3Dator/3dator/3Dator.JPG

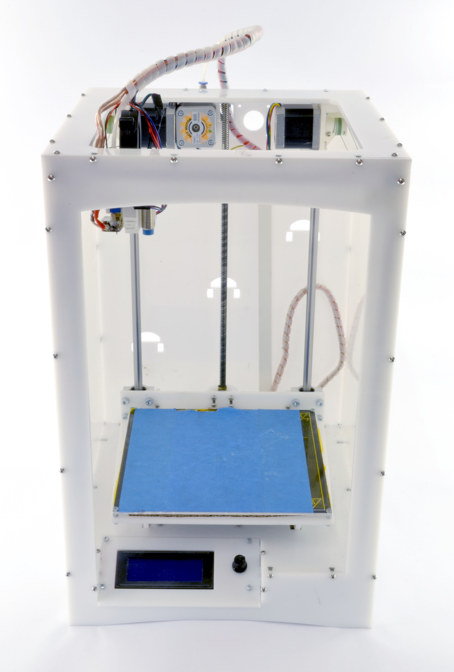
3Dator.JPG
