3Dator/3dator/README.md

3Dator
======

This repository will provide you with all informations on parts used in the 3Dator 3D printer.

For more information visit our website or wiki:
You will find a detailed list of all needed parts here: http://wiki.3dator.com/index.php/BOM

http://3dator.com

http://wiki.3dator.com

Please note that the material in this repository is licensed with the CC BY-NC-SA
