3Dator/3dator/dxf/Laser_layout.step

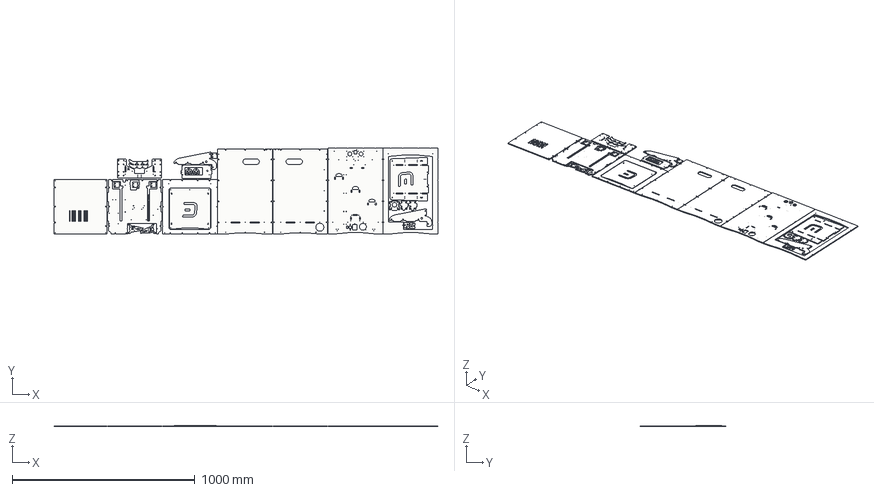
[picture p2: CAD file, 2017-05-03]
dxf/Laser_layout.step
2102.0 x 471.8 x 7.51 mm
case_display_tilter v3 x 2
case_display v3
z_sled_back v2
z_sled_support v2 x 2
z_sled_main v2
5mm_spacer v2 x 17
spool_holder_support v2 x 2
test_edge v2 x 4
z_motor_mount_support v2 x 2
z_motor_mount_main v3
z_nut_holder v3 x 2
case_left v4
case_floor v5
bed_carrier v6
case_front v4
case_right v3
case_top v7
case_bottom v4
case_back v7
spool_holder_main v2 x 2
