3Dator/3dator/Slicer profile/Cura 2.5/3dator_platform.stl

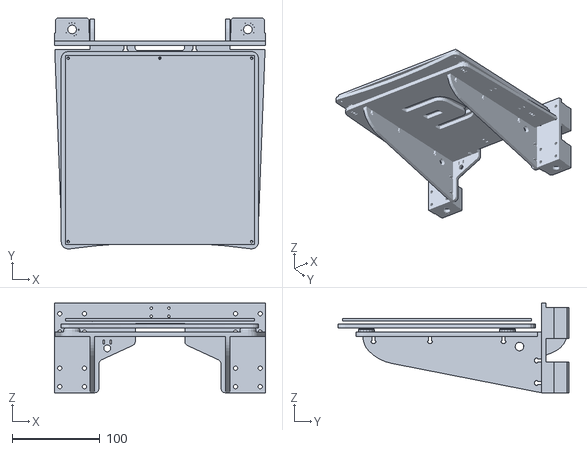
[picture p3: CAD file, 2017-05-23]
Slicer profile/Cura 2.5/3dator_platform.stl
240.0 x 262.7 x 102.0
