3Dator/3dator/step/extra/cable_anchor.stp

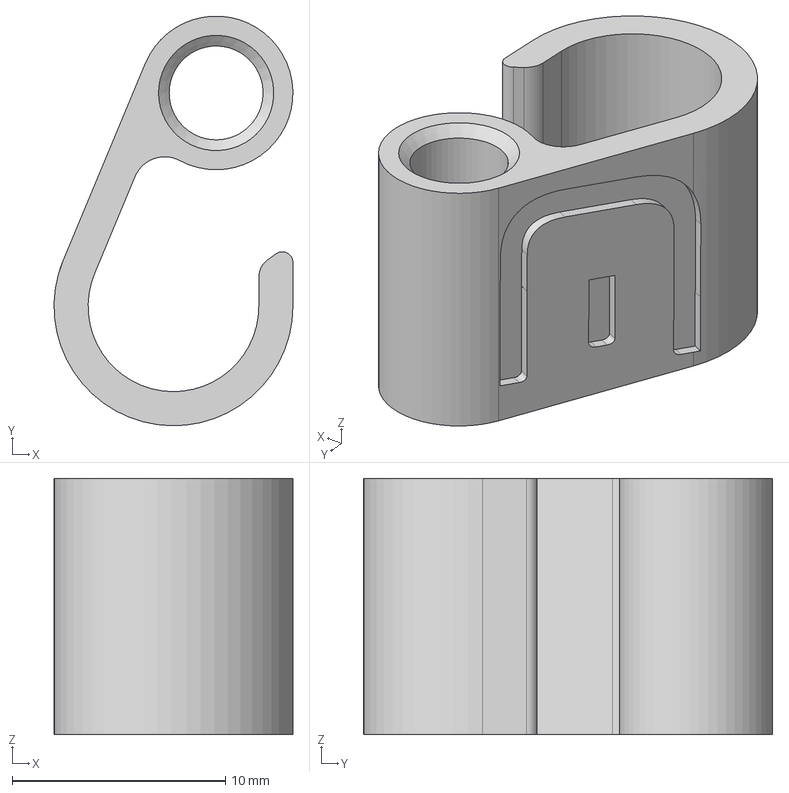
[picture p4: CAD file, 2017-03-16]
step/extra/cable_anchor.stp
11.2 x 19.2 x 12.0 mm
