3Dator/3dator/step/extra/extruder_mirrored/tightener.stp

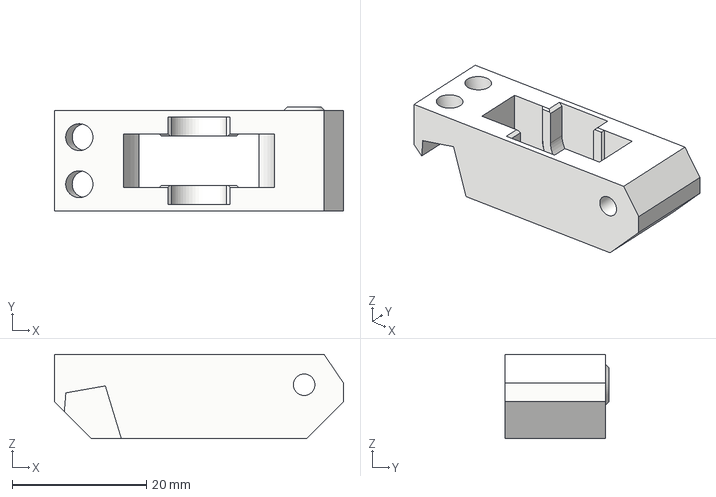
[picture p5: CAD file, 2017-03-09]
step/extra/extruder_mirrored/tightener.stp
43.0 x 15.5 x 12.5 mm
