3Dator/3dator/step/extruder/adapter.stp

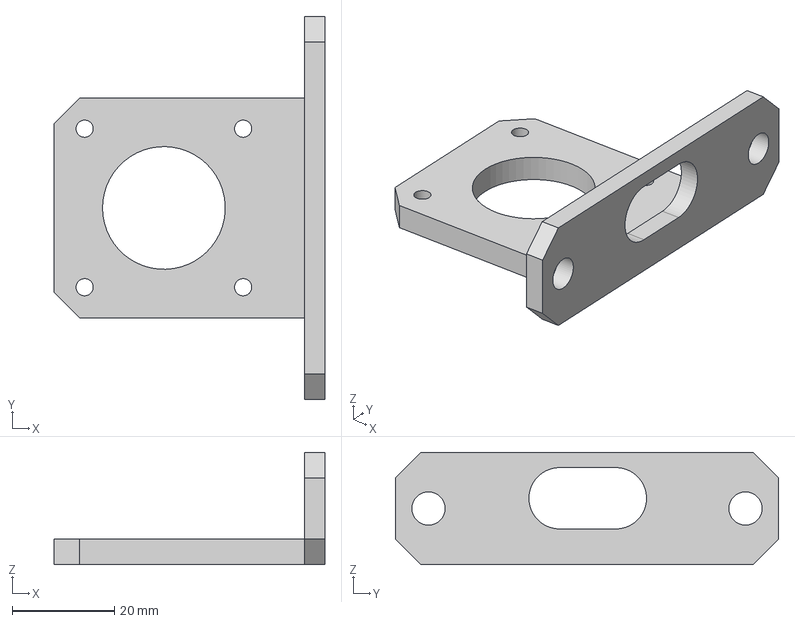
[picture p6: CAD file, 2017-08-22]
step/extruder/adapter.stp
53.0 x 75.0 x 22.0 mm
