3Dator/3dator/step/printhead/printhead.step

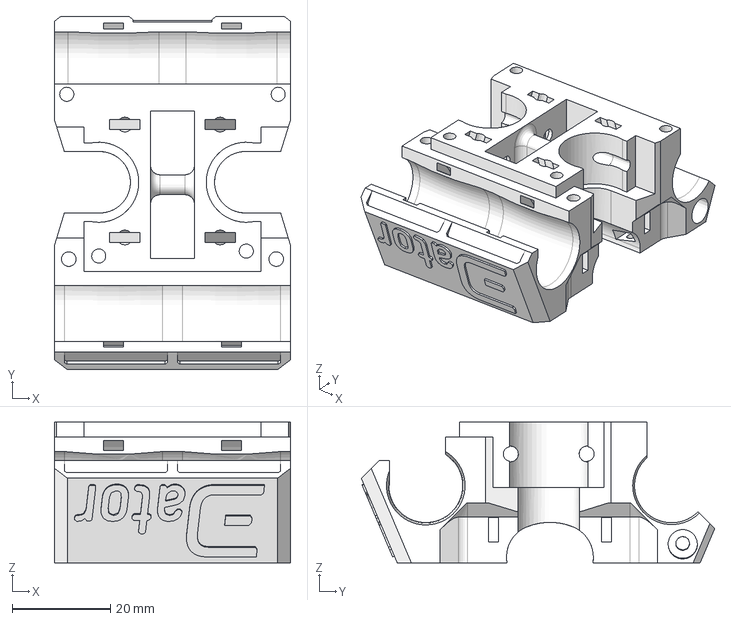
[picture p7: CAD file, 2017-07-11]
step/printhead/printhead.step
48.0 x 71.9 x 28.7 mm
