3Dator/3dator/step/xy_motor_carrier_left.step

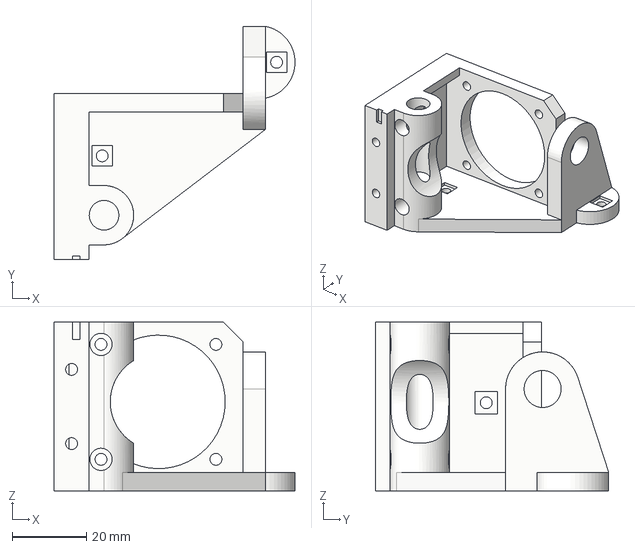
[picture p8: CAD file, 2017-07-11]
step/xy_motor_carrier_left.step
65.0 x 63.0 x 45.5 mm
