3Dator/3dator/stl/extruder/print_parts_extruder.stl

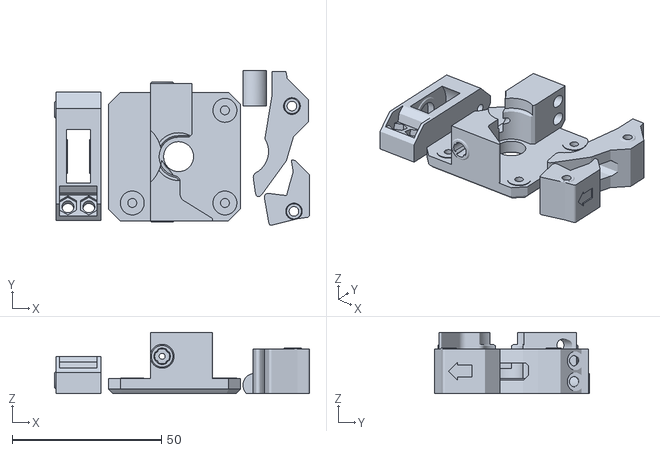
[picture p9: CAD file, 2017-03-23]
stl/extruder/print_parts_extruder.stl
85.3 x 51.7 x 20.5
