3Dator/3dator/step/extra/cooling_tube_dual.stp

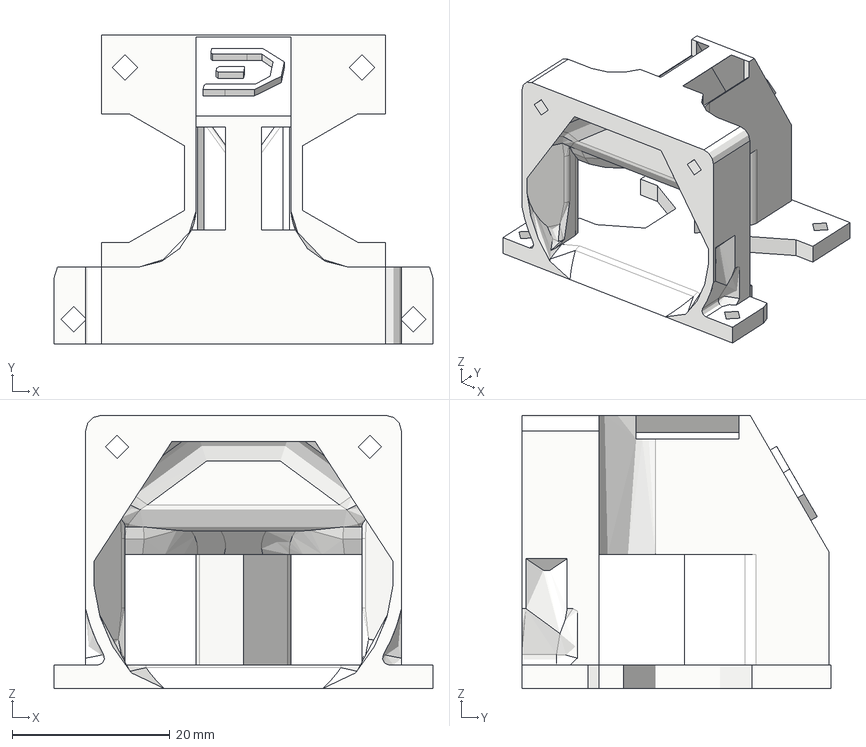
[picture p10: CAD file, 2017-03-09]
step/extra/cooling_tube_dual.stp
48.0 x 39.1 x 34.6 mm
