3Dator/3dator/step/extra/extruder_mirrored/hook_with_hole.stp

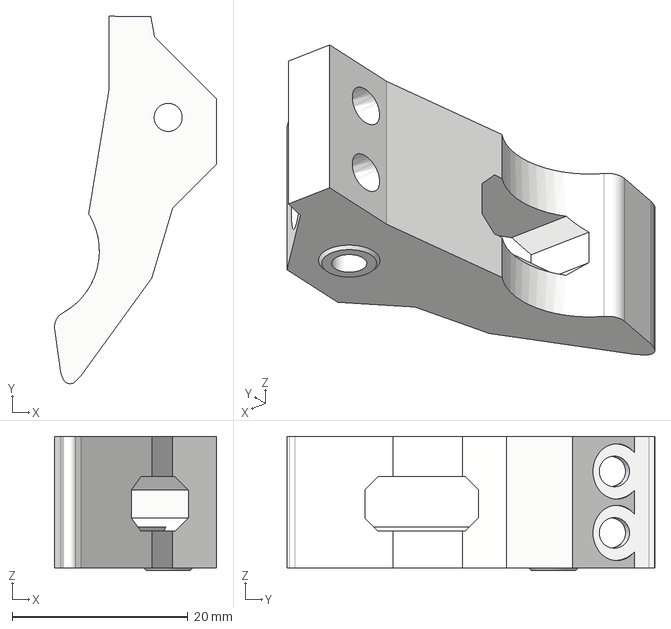
[picture p11: CAD file, 2017-03-09]
step/extra/extruder_mirrored/hook_with_hole.stp
18.4 x 41.9 x 15.3 mm
