3Dator/3dator/step/extruder/tightener.step

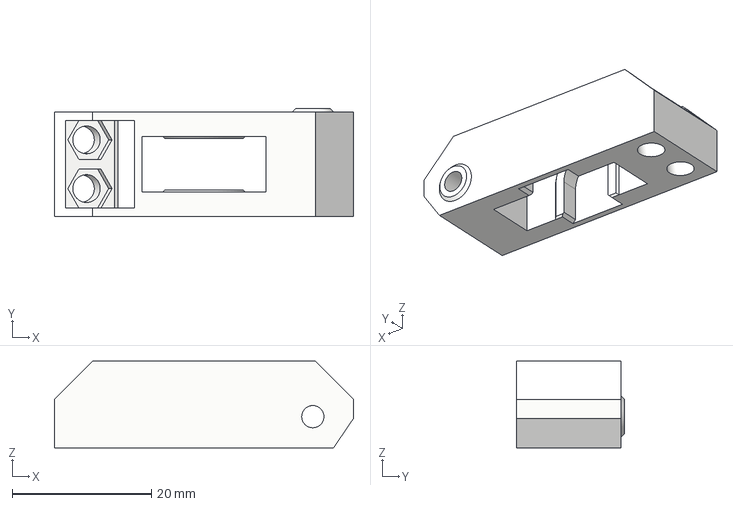
[picture p12: CAD file, 2017-03-23]
step/extruder/tightener.step
43.0 x 15.5 x 12.5 mm
