3Dator/3dator/step/printhead/endstop_holder.step

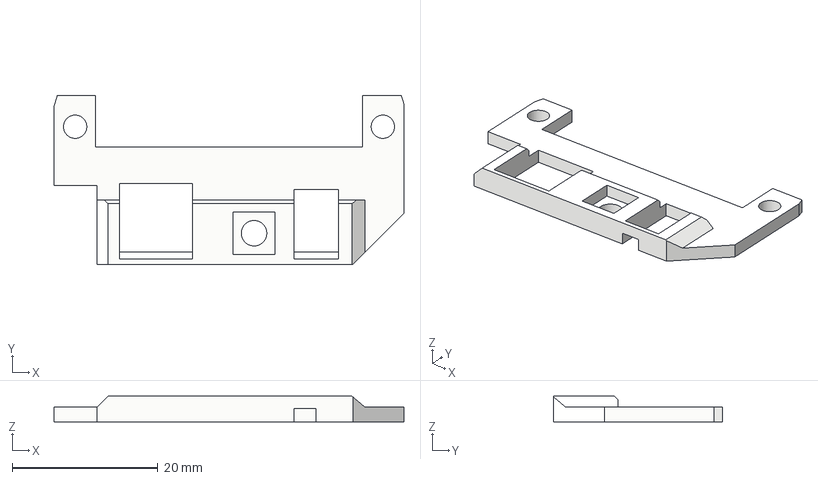
[picture p13: CAD file, 2017-06-19]
step/printhead/endstop_holder.step
48.0 x 23.1 x 3.50 mm
