3Dator/3dator/step/extra/extruder_mirrored/hook.stp

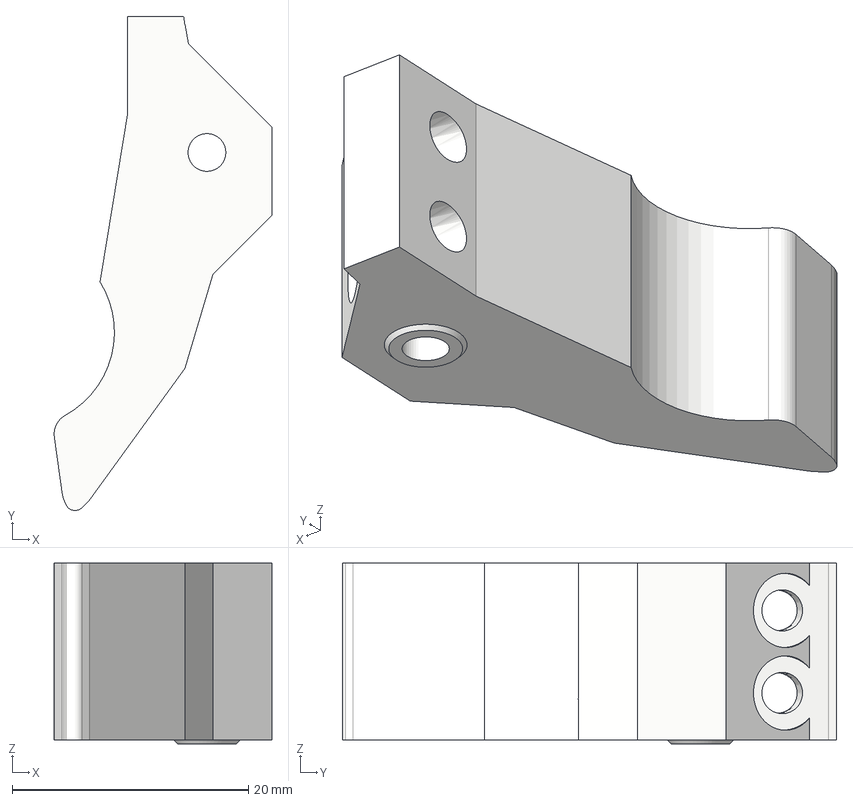
[picture p14: CAD file, 2017-03-09]
step/extra/extruder_mirrored/hook.stp
18.4 x 41.9 x 15.3 mm
