3Dator/3dator/step/extruder/lever.step

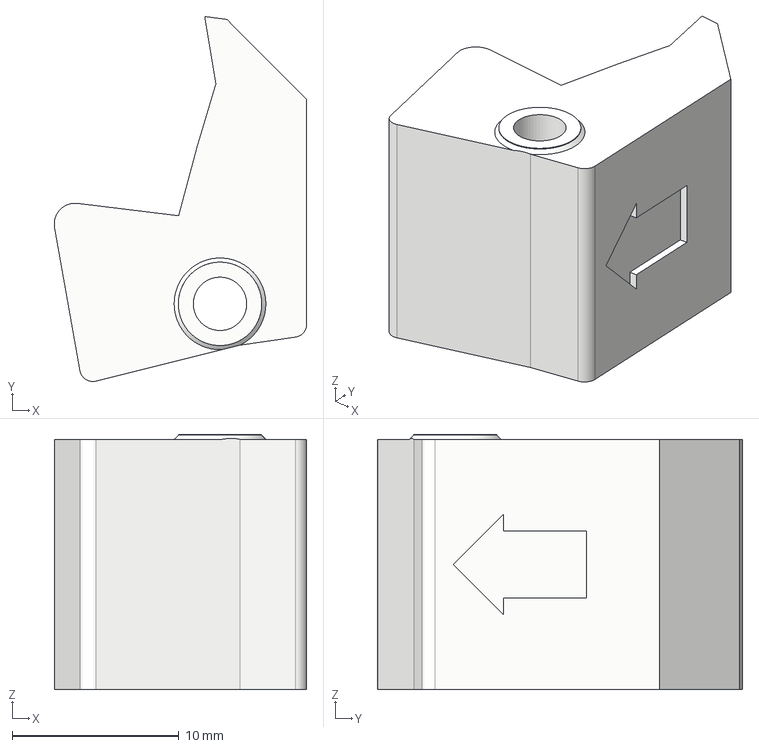
[picture p15: CAD file, 2017-03-09]
step/extruder/lever.step
15.1 x 21.9 x 15.3 mm
