3Dator/3dator/step/printhead/hotend_clamp.step

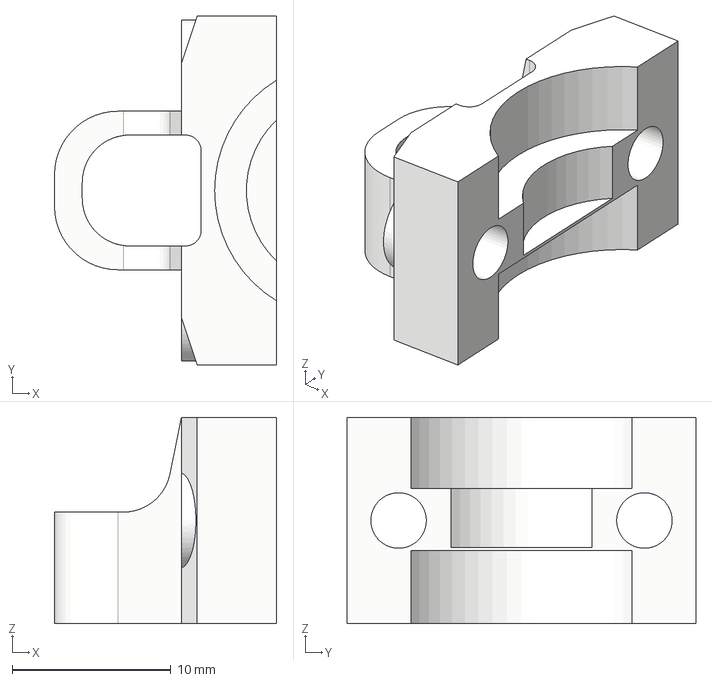
[picture p16: CAD file, 2017-03-09]
step/printhead/hotend_clamp.step
14.0 x 22.0 x 13.0 mm
