3Dator/3dator/step/pulley.step

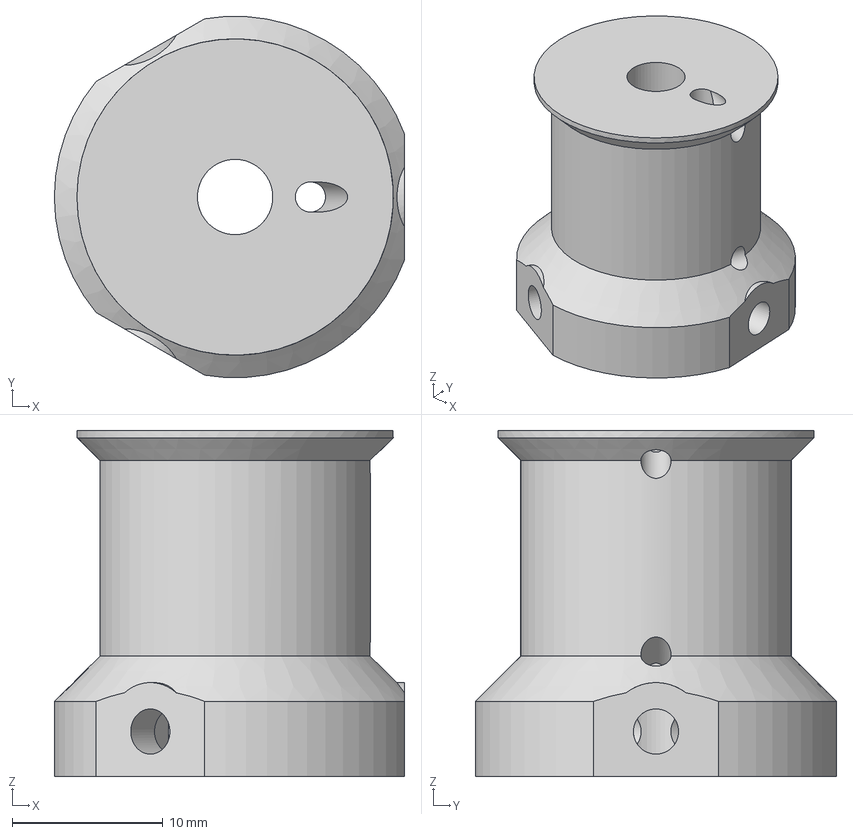
[picture p17: CAD file, 2017-03-16]
step/pulley.step
23.3 x 24.0 x 23.0 mm
