3Dator/3dator/step/extra/extruder_mirrored/axle.stp

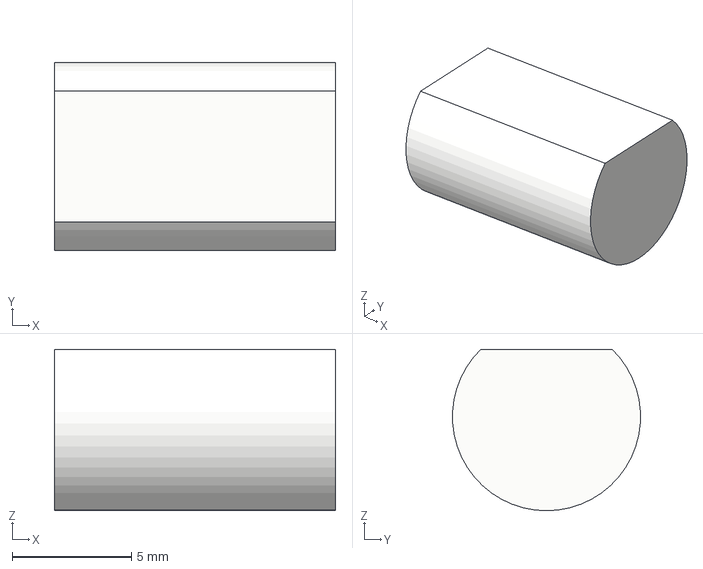
[picture p18: CAD file, 2017-03-09]
step/extra/extruder_mirrored/axle.stp
11.8 x 7.89 x 6.78 mm
