3Dator/3dator/step/extruder/extruder_base.step

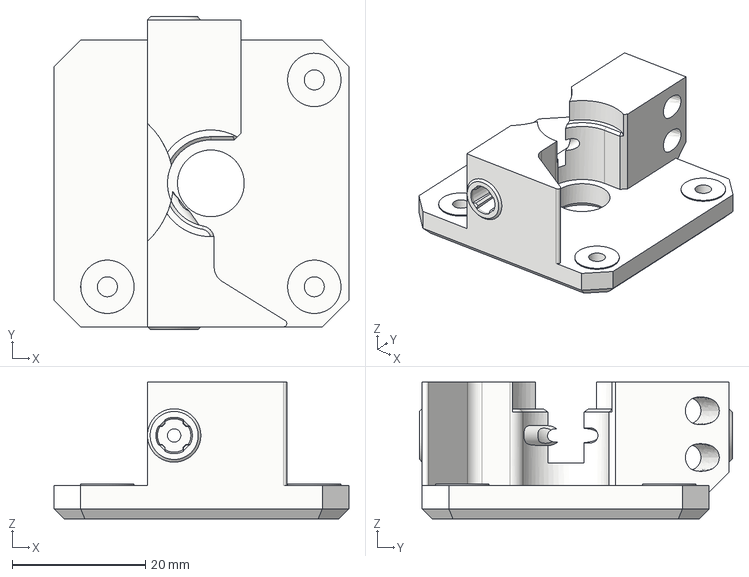
[picture p19: CAD file, 2017-03-09]
step/extruder/extruder_base.step
44.2 x 46.9 x 20.5 mm
