3Dator/3dator/step/idler_right.step

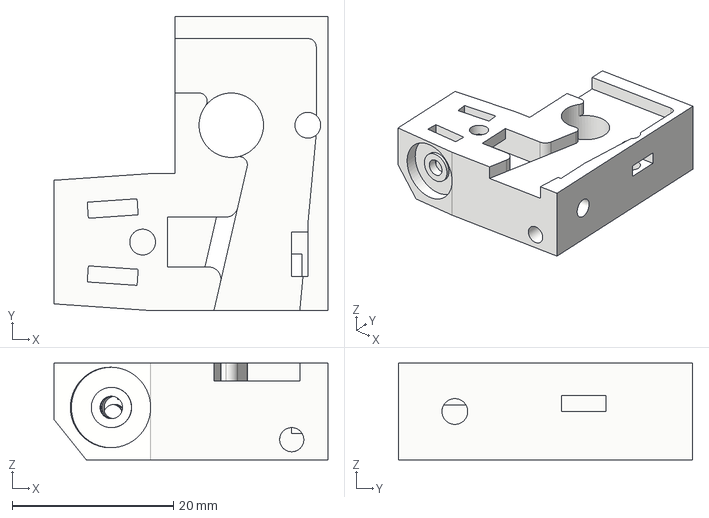
[picture p20: CAD file, 2017-03-09]
step/idler_right.step
34.0 x 36.5 x 12.0 mm
