3Dator/3dator/step/printhead/cooling_tube.step

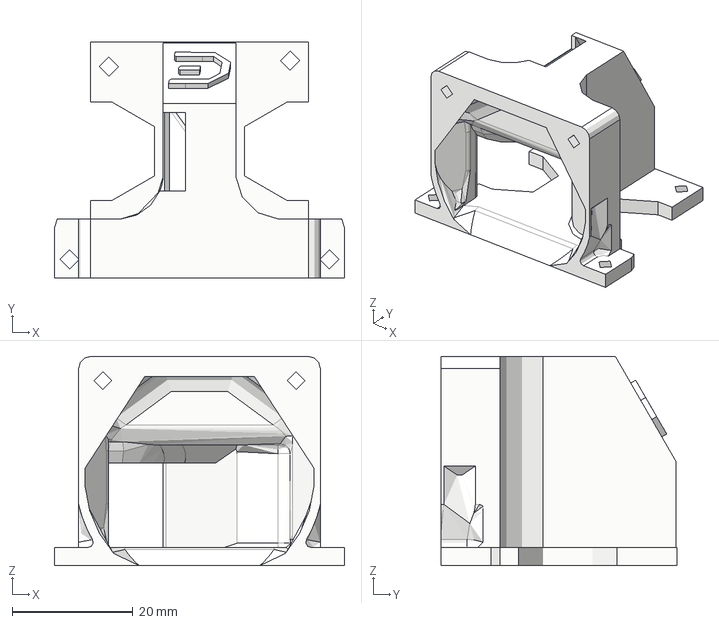
[picture p21: CAD file, 2017-03-09]
step/printhead/cooling_tube.step
48.0 x 39.1 x 34.6 mm
