3Dator/3dator/step/printhead/sensor_spacer.stp

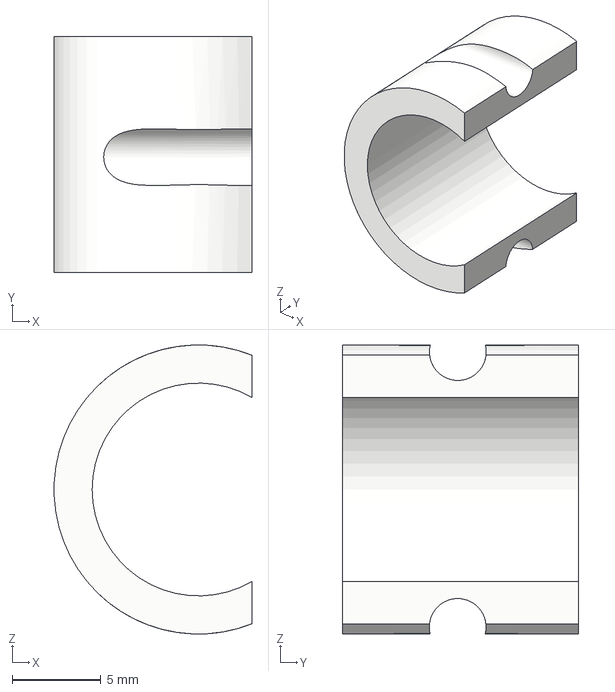
[picture p22: CAD file, 2017-03-09]
step/printhead/sensor_spacer.stp
11.1 x 13.3 x 16.3 mm
