3Dator/3dator/step/y_carrier_printpart.step

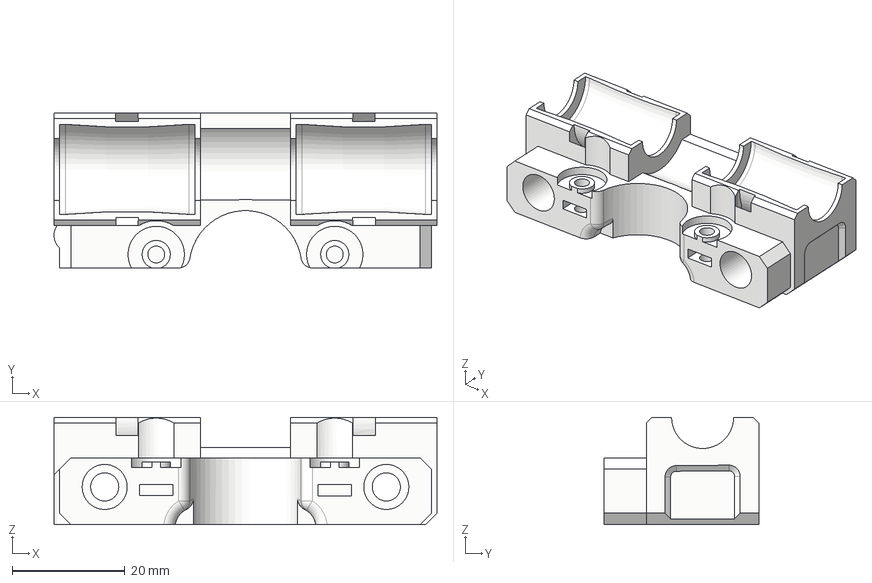
[picture p23: CAD file, 2017-03-09]
step/y_carrier_printpart.step
68.0 x 27.5 x 19.0 mm
