3Dator/3dator/step/printhead/sensor_clamp.step

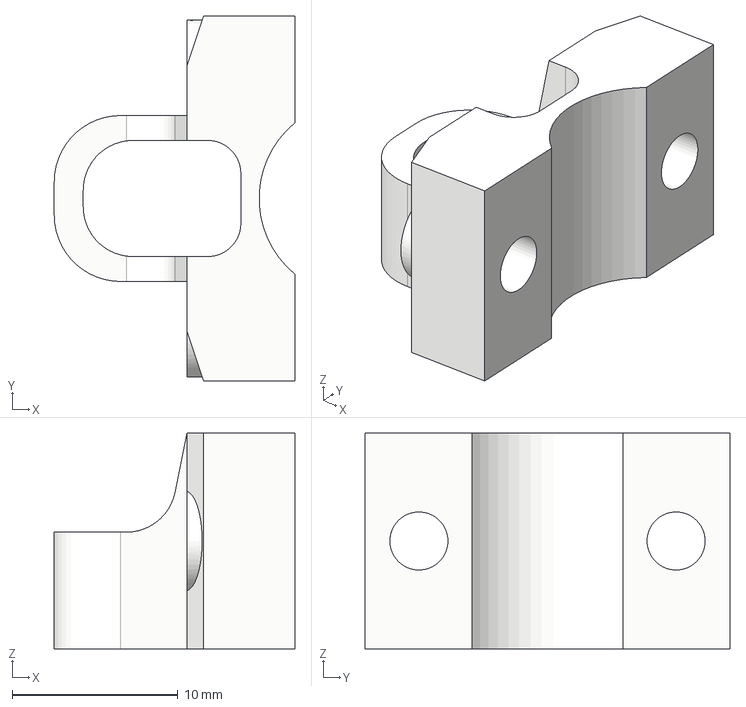
[picture p24: CAD file, 2017-03-09]
step/printhead/sensor_clamp.step
14.5 x 22.0 x 13.0 mm
