3Dator/3dator/step/z_rod_holder_right.step

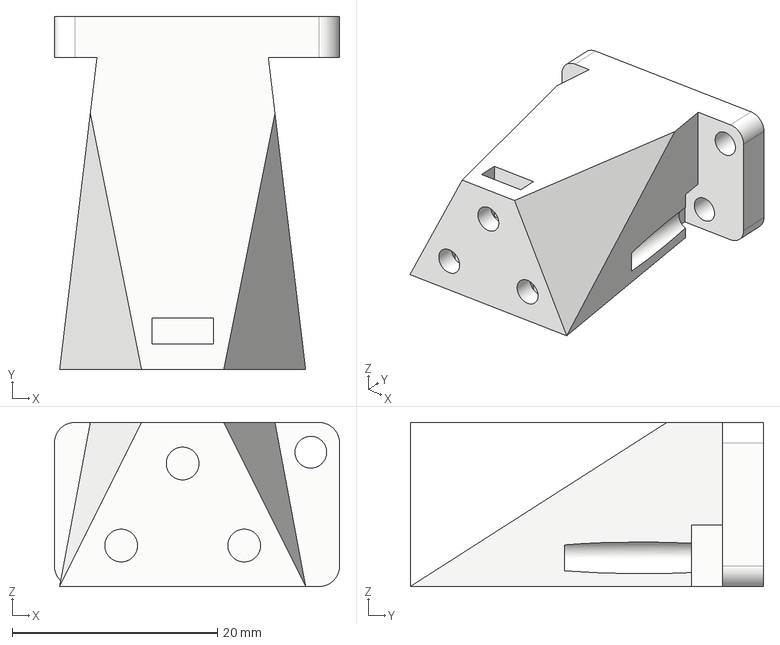
[picture p25: CAD file, 2017-03-09]
step/z_rod_holder_right.step
27.8 x 34.4 x 16.0 mm
