3Dator/3dator/step/idler_left.step

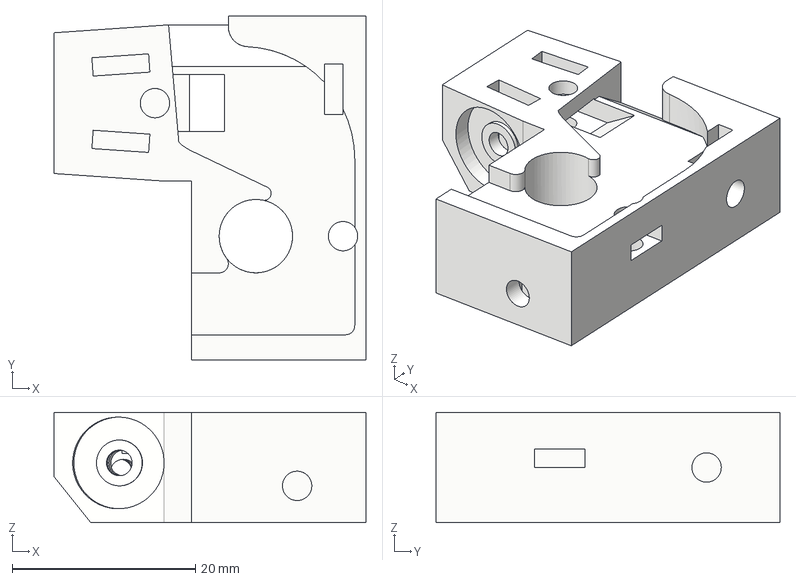
[picture p26: CAD file, 2017-03-09]
step/idler_left.step
34.0 x 37.5 x 12.0 mm
