3Dator/3dator/step/z_rod_holder_left.step

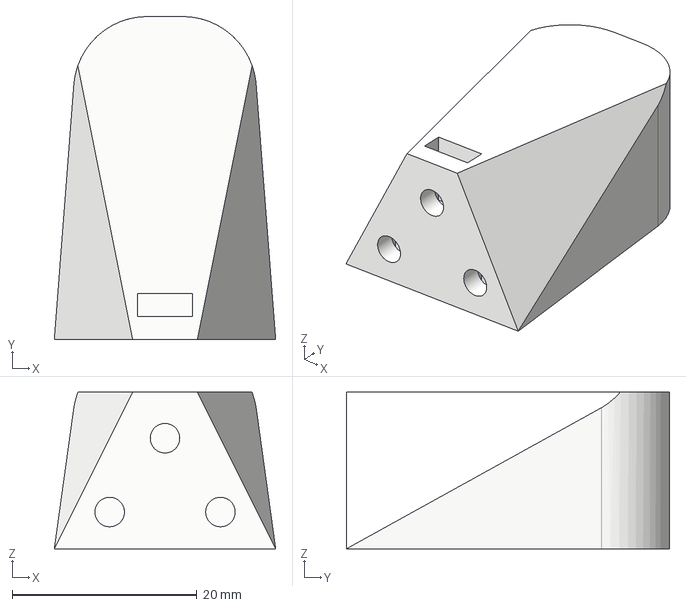
[picture p27: CAD file, 2017-03-09]
step/z_rod_holder_left.step
24.0 x 35.0 x 17.0 mm
