3Dator/3dator/(list of files, cad)

Other CAD files:
Slicer profile/simplify3d/3dator_printbed.stl
step/xy_motor_carrier_right.step
step/extra/extruder_mirrored/extruder_base.stp
step/extruder/hook_with_hole.stp
step/extra/extruder_mirrored/lever.stp
step/extruder/axle.step
step/extruder/hook.step
dxf/laser_layout.dxf
stl/extra/cable_anchor.stl
stl/extra/cooling_tube_dual.stl
stl/extra/extruder_mirrored/axle.stl
stl/extra/extruder_mirrored/extruder_base.stl
stl/extra/extruder_mirrored/hook.stl
stl/extra/extruder_mirrored/hook_with_hole.stl
stl/extra/extruder_mirrored/lever.stl
stl/extra/extruder_mirrored/tightener.stl
stl/extruder/adapter.stl
stl/extruder/axle.stl
stl/extruder/extruder_base.stl
stl/extruder/hook.stl
stl/extruder/hook_with_hole.stl
stl/extruder/lever.stl
stl/extruder/tightener.stl
stl/idler_left.stl
stl/idler_right.stl
stl/printhead/cooling_tube.stl
stl/printhead/endstop_holder.stl
stl/printhead/hotend_clamp.stl
stl/printhead/printhead.stl
stl/printhead/sensor_clamp.stl
stl/printhead/sensor_spacer.stl
stl/pulley.stl
stl/xy_motor_carrier_left.stl
stl/xy_motor_carrier_right.stl
stl/y_carrier_printpart.stl
stl/z_rod_holder_left.stl
stl/z_rod_holder_right.stl
