3Dator/3dator/(commit log)

2015-08-15 first commit of stl and dxf files
    [axle.stl, cooling_tube.stl, endstop_holder.stl, extruder_base.stl, hook.stl, laser_parts.dxf, lever.stl, printhead.stl]
2015-10-10 updated BOM, laser parts and print parts
    [cooling_tube.stl, endstop_holder.stl, hotend_clamp.stl, laser_parts.dxf, printhead.stl, pulley.stl, sensor_clamp.stl, xy_idler_left.stl]
2015-11-30 updated all parts
    [axle.stl, cooling_tube.stl, endstop_holder.stl, extruder_base.stl, hook.stl, hotend_clamp.stl, laser_parts.dxf, lever.stl]
2016-01-15 improvements for some parts
    [cooling_tube.stl, endstop_holder.stl, extruder_base.stl, printhead.stl, xy_idler.stl, xy_idler_left.stl, y_carrier_printpart.stl]
2016-02-29 updated BOM and added simplify 3D ini file
2016-03-01 updated stls for newest version
    [axle.stl, cooling_tube.stl, endstop_holder.stl, hook.stl, hotend_clamp.stl, idler_left.stl, idler_right.stl, lever.stl]
2016-03-01 added step files
    [axle.step, cooling_tube.step, endstop_holder.step, hook.step, hotend_clamp.step, idler_left.step, idler_right.step, lever.step]
2016-03-11 updated laser parts (dxf)
    [laser_parts.dxf]
2016-04-24 updated extruder, y_carrier_printpart
    [extruder_base.stl, hook.stl, lever.stl, tightener.stl, y_carrier_printpart.stl]
2016-04-24 updated step files for extruder and y_carrier_printpart
    [extruder_base.step, hook.step, lever.step, tightener.step, y_carrier_printpart.step]
2016-08-09 optimised extruder for better material flow, added mirrored extruder
    [axle.stl, axle.stp, extruder_base.step, extruder_base.stl, extruder_base.stp, hook.stl, hook.stp, hook_with_hole.stl]
2016-08-09 minor impovements on y_carrier_printpart
    [hook_with_hole.stl, y_carrier_printpart.step, y_carrier_printpart.stl]
2016-08-31 added new versions of idler and printhead, added all parts in one file
    [all_parts.step, idler_left.step, idler_left.stl, idler_right.step, idler_right.stl, printhead.step, printhead.stl]
2016-09-06 updated laser layout
    [laser_layout.dxf, laser_parts.dxf]
2016-11-06 added multiple extra fan tubes for different hotends
    [axle.stl, axle.stp, cooling_tube_dual.stl, cooling_tube_dual.stp, cooling_tube_dyze.stl, cooling_tube_dyze.stp, cooling_tube_e3d.stl, cooling_tube_e3d.stp]
2016-11-12 made floor thicker where z rods rest+
    [xy_motor_carrier_right.step, z_rod_holder_left.step, z_rod_holder_left.stl, z_rod_holder_right.stl]
2017-01-25 added screws for magnets on y carrier printpart
    [y_carrier_printpart.step, y_carrier_printpart.stl]
2017-03-09 updated laser layout and idlers (not better spot for screws)
    [Laser_layout.step, all_parts.step, axle.step, axle.stp, cooling_tube.step, cooling_tube_dual.stp, cooling_tube_dyze.stp, cooling_tube_e3d.stp]
2017-03-14 Updated Pulley Design
    Removed the rectangular M3 Nut and replaced it with 3 self locking M3
    Hex nuts to prevent the Screws from loosening. The pulley can now be
    fixed with 3x 10mm long M3 screws. Also the base was widened up, to
    give the screws more grip.
    [pulley.step, pulley.stl]
2017-03-16 added full step file, added cable_anchor
    [cable_anchor.stl, cable_anchor.stp]
2017-03-23 updated tightener to use safe M3 nut
    [tightener.step, tightener.stl]
2017-03-23 also updated extruder print parts
    [print_parts_extruder.stl]
2017-04-19 removed Bom.PDF
    You will find the BOM in our Wiki.
    http://wiki.3dator.com/index.php/BOM
2017-04-26 moded some mods and upgrades to 3dator_mods repo
    [cooling_tube_dyze.stl, cooling_tube_dyze.stp, cooling_tube_e3d.stl, cooling_tube_e3d.stp, cooling_tube_e3d_volcano.stl, cooling_tube_e3d_volcano.stp, y_splitter.stl, y_splitter.stp]
2017-04-27 updated Slicer profiles and added heatbed.stl
    Have a look in our Wiki to see, how to integrate these profiles in your
    Slicer.
    http://wiki.3dator.com/index.php/Slicer_Voreinstellungen
    [3dator_printbed.stl]
2017-05-23 added new cura config
    [3dator_platform.stl, 3dator_printbed.stl]
2017-06-19 updated endstop holder
    [endstop_holder.step, endstop_holder.stl]
2017-06-22 fixed bug with holes in printhead
    [printhead.step, printhead.stl]
2017-07-11 updated wrong files for xy motor carrier
    [xy_motor_carrier_left.step, xy_motor_carrier_left.stl, xy_motor_carrier_right.step, xy_motor_carrier_right.stl]
2017-08-22 added new adapter
    [adapter.stl, adapter.stp]
